cincodenada/old_controllers-pcb/controllerpro.kicad_pcb

## KiCad design controllerpro.kicad_pcb (2019-10-11)

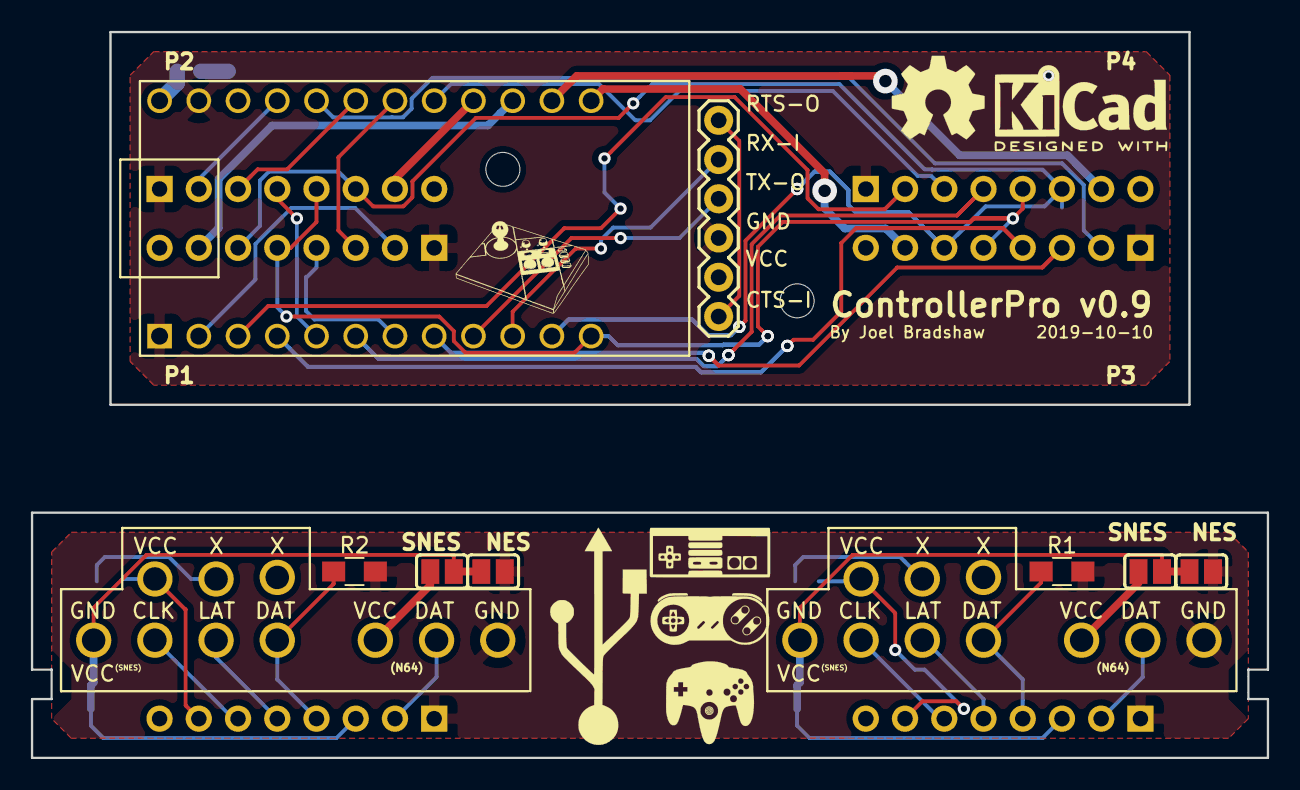
[picture p32: board controllerpro.kicad_pcb from above]

Board: 2 copper layers, 80.0 x 47.0 mm, 21 parts (0 on the bottom side), 40 nets.

Parts:
JP1, JP3, JP4, JP6, JP7, JP8, JP9: SolderJumper_2_Open; SOLDERJUMPER
JP2, JP5: SolderJumper_2_Bridged; SOLDERJUMPER
P1, P2: Conn_01x08_Male; PinHeader_1x08_P2.54mm_Vertical
R1, R2: 10k; R_0805_HandSoldering
S1, S2, S3, S4: Conn_01x08_Female; Socket_Strip_Angled_1x08_Pitch2.54mm
U1: Teensy3.2; Teensy30_31_32_LC
U2: RN42
U3, U4: NINTENDO-MULTI_LARGE; NINTENDO-MULTI

Connections:
/BT_RX: U1.10, U2.RX-I
/BT_TS: U2.CTS-I, U2.RTS-0
/BT_TX: U1.9, U2.TX-0
/CLOCK: S1.6, S2.6, S3.6, S4.6, U1.11
/Child Board/CLK_A: P2.6, U3.2
/Child Board/CLK_B: P1.6, U4.2
/Child Board/ENABLE_A: JP8.1, P2.7, U3.10
/Child Board/ENABLE_B: JP9.1, P1.7, U4.10
/Child Board/FAST_DATA_A: P2.2, U3.6
/Child Board/FAST_DATA_B: P1.2, U4.6
/Child Board/LATCH_A: P2.5, U3.3
/Child Board/LATCH_B: P1.5, U4.3
/Child Board/SLOW_DATA_A: P2.4, R1.1, U3.4
/Child Board/SLOW_DATA_B: P1.4, R2.1, U4.4
/Child Board/S_OR_NES_A: JP2.1, JP2.2, JP3.2, JP4.1, P2.3, U3.1
/Child Board/S_OR_NES_B: JP5.1, JP5.2, JP6.2, JP7.1, P1.3, U4.1
/LATCH: S1.5, S2.5, S3.5, S4.5, U1.12
ENABLE1: S1.7, U1.24
ENABLE2: S2.7, U1.25
ENABLE3: S3.7, U1.22
ENABLE4: S4.7, U1.23
FAST_DATA1: S1.2, U1.2
FAST_DATA2: S2.2, U1.30
FAST_DATA3: S3.2, U1.29
FAST_DATA4: S4.2, U1.3
GND: S1.1, S2.1, S3.1, S4.1, U1.1, U1.32, U2.GND
GNDA: JP4.2, JP7.2, P1.1, P2.1, R1.2, R2.2, U3.7, U4.7
unnamed: JP1.2, U1.33
unnamed: JP8.2, U3.9
unnamed: JP9.2, U4.9
SLOW_DATA1: S1.4, U1.7
SLOW_DATA2: S2.4, U1.5
SLOW_DATA3: S3.4, U1.4
SLOW_DATA4: S4.4, U1.6
S_OR_NES1: S1.3, U1.27
S_OR_NES2: S2.3, U1.28
S_OR_NES3: S3.3, U1.8
S_OR_NES4: S4.3, U1.26
VCC: JP1.1, S1.8, S2.8, S3.8, S4.8, U1.31, U2.VCC
VCCA: JP3.1, JP6.1, P1.8, P2.8, U3.5, U4.5
