cincodenada/old_controllers-pcb/(commit log)

2018-03-31 Initial commit from import
    [controllerpro.kicad_pcb, controllerpro.sch]
2018-03-31 Align board to grid, add border for small board
    [controllerpro.kicad_pcb]
2018-03-31 Add headers, lots of rearranging/tidying
    [controllerpro.sch]
2018-03-31 Shorted connectors to test connectivity
    [controllerpro.sch]
2018-03-31 Revert "Shorted connectors to test connectivity"
    This reverts commit bff4c321492e34593da7785c8a90028fe11ea69b.
    [controllerpro.sch]
2018-04-01 Match footprints and re-label
    [controllerpro.kicad_pcb, controllerpro.sch]
2018-04-01 Move second set of multiports
    [controllerpro.kicad_pcb]
2018-04-01 Start laying out board
    [controllerpro.kicad_pcb]
2018-04-01 More layout
    [controllerpro.kicad_pcb]
2018-04-01 Remove stray vcc labels
    [controllerpro.sch]
2018-04-01 Make it default to configurable SNES/NES
    [controllerpro.kicad_pcb, controllerpro.sch]
2018-04-01 Finish initial layout of first port
    [controllerpro.kicad_pcb]
2018-04-01 Fix port numbers
    That was annoying, but fine
    [controllerpro.kicad_pcb, controllerpro.sch]
2018-04-01 Place remainder of big footprints
    Resistors still to do
    [controllerpro.kicad_pcb]
2018-04-01 Clear out existing tracks
    [controllerpro.kicad_pcb, controllerpro.sch]
2018-04-01 Connect first two terminals (the easy ones)
    [controllerpro.kicad_pcb]
2018-04-01 Initial complete connection
    [controllerpro.kicad_pcb]
2018-04-01 Scootch the connectors closer
    They're the constraining factor here
    [controllerpro.kicad_pcb]
2018-04-01 First attempt at shrinking board
    [controllerpro.kicad_pcb]
2018-04-01 Tie up loose ends from shrinking board
    [controllerpro.kicad_pcb]
2018-04-01 Fix misalignment/non-centering of pins
    [controllerpro.kicad_pcb]
2018-04-01 Add keepout for bluetooth
    [controllerpro.kicad_pcb]
2018-04-01 Make daughterboards smaller
    [controllerpro.kicad_pcb]
2018-04-01 Attempt to add zones to daughterboard
    [controllerpro.kicad_pcb]
2018-04-01 Work on zones on daughterboards
    Still some figuring to do
    [controllerpro.kicad_pcb, controllerpro.sch]
2018-04-08 Update headers with actual footprint
    [controllerpro.kicad_pcb]
2018-04-08 Update resistor placement
    [controllerpro.kicad_pcb]
2018-04-08 Import solder jumpers from Teensy
    Better than caps/resistors
    [controllerpro.kicad_pcb]
2018-04-08 Set up DRCs for OSHPark
    [controllerpro.kicad_pcb]
2018-04-08 Move measurements to Dwg layer
    WTF silkscreens
    [controllerpro.kicad_pcb]
2018-04-08 Switch Teensy package
    [controllerpro.sch]
2018-04-08 Fix pins on new Teensy
    [controllerpro.sch]
2018-04-08 Update boardfile
    [controllerpro.kicad_pcb]
2018-04-08 Fix board
    [controllerpro.kicad_pcb]
2018-08-09 Remove duplicate board, add cutouts
    [controllerpro.kicad_pcb, controllerpro.sch]
2018-08-09 Update to new libraries and fix buses
    [controllerpro.sch]
2018-08-09 Remove second board from schematic
    [controllerpro.kicad_pcb, controllerpro.sch]
2019-02-05 Add pulldown resistors, shrink child board
    [controllerpro.kicad_pcb, controllerpro.sch]
2019-02-05 Switch to Teensy 3.2 footprint
    [controllerpro.kicad_pcb, controllerpro.sch]
2019-02-05 More 3.2 adjustments
    Make it Teensy2 compatible even, hopefully!
    [controllerpro.kicad_pcb, controllerpro.sch]
2019-02-05 Switch to solder bridges for the SNES mode selectors
    [controllerpro.kicad_pcb, controllerpro.sch]
2019-02-06 Make controller pin holes smaller
    Finally found a datasheet that recommends a reasonable size
    [controllerpro.kicad_pcb]
2019-02-06 Shrink top board considerably
    So much empty space!
    [controllerpro.kicad_pcb]
2019-02-06 Make the bottom board smaller!
    SMALLER SMALLER SMALLER
    [controllerpro.kicad_pcb]
2019-02-06 Silkscreen!!
    Logos! Labels!
    [controllerpro.kicad_pcb]
2019-02-08 Nudge bluetooth, refining silkscreen/labels
    [controllerpro.kicad_pcb, controllerpro.sch]
2019-02-18 Fixes from hardware debugging
    Connect daughterboards to ground (!)
    [controllerpro.kicad_pcb, controllerpro.sch]
2019-02-18 Split LATCH into four
    Also fix misplaced NES VCC (!!) and ports
    [controllerpro.kicad_pcb, controllerpro.sch]
2019-02-18 Make power traces thicker
    [controllerpro.kicad_pcb]
2019-03-14 More tidying
    [controllerpro.kicad_pcb, controllerpro.sch]
2019-03-14 Manually rename ports
    Also match board by timestamp, nice!
    perl -p -i -e 's/\b(PORT|S|P|5VDATA|3VDATA|S_OR_NES|LATCH)1\b/${1}4/g' *
    perl -p -i -e 's/\b(PORT|S|P|5VDATA|3VDATA|S_OR_NES|LATCH)2\b/${1}1/g' *
    perl -p -i -e 's/\b(PORT|S|P|5VDATA|3VDATA|S_OR_NES|LATCH)3\b/${1}2/g' *
    perl -p -i -e 's/\b(PORT|S|P|5VDATA|3VDATA|S_OR_NES|LATCH)0\b/${1}3/g' *
    perl -p -i -e 's/\b(PORT|S|P|5VDATA|3VDATA|S_OR_NES|LATCH)\[0..3\]/${1}[1..4]/g' *
    [controllerpro.kicad_pcb, controllerpro.sch]
2019-03-14 Re-add silkscreens
    [controllerpro.kicad_pcb]
2019-03-15 Silkscreen tweaks
    [controllerpro.kicad_pcb]
2019-03-15 Fix a needlessly squiggly trace
    [controllerpro.kicad_pcb]
2019-08-03 Add a couple more measurements
    [controllerpro.kicad_pcb]
2019-08-03 Add child board heirarchical sheet
    [ChildBoard.sch, controllerpro.sch]
2019-08-04 Move back to one latch, instead try current detect
    [ChildBoard.sch, controllerpro.kicad_pcb, controllerpro.sch]
2019-08-04 Fix connector orientation, get rid of tabs
    [controllerpro.kicad_pcb]
2019-08-04 Move RN42 board
    It's on top which is great but needs to be out from under the Teensy
    [controllerpro.kicad_pcb]
2019-08-04 Switch S_OR_NES and DETECT
    So we can do analog measurements on DETECT
    Abandon running wider lines for these, it'll probably be fine
    [controllerpro.kicad_pcb, controllerpro.sch]
2019-08-05 Connect AGND
    [controllerpro.kicad_pcb, controllerpro.sch]
2019-08-05 Rename a bunch of stuff, switch DETECT back
    [controllerpro.sch]
2019-08-05 Move things around so everything that needs touch has it
    [controllerpro.sch]
2019-08-09 Fix the board up after moving all the pins around
    [ChildBoard.sch, controllerpro.kicad_pcb, controllerpro.sch]
2019-08-09 Fuck the schematic all up
    [ChildBoard.sch, controllerpro.sch]
2019-08-09 Start repairs
    [controllerpro.kicad_pcb]
2019-08-09 Finish reworking all the things
    [ChildBoard.sch, controllerpro.kicad_pcb, controllerpro.sch]
2019-08-09 Use local labels instead of global and add NCs
    [ChildBoard.sch, controllerpro.sch]
2019-08-09 I don't even know what I did this time
    [ChildBoard.sch, controllerpro.kicad_pcb, controllerpro.sch]
2019-08-09 Silkscreen updates, tiny tweaks
    [controllerpro.kicad_pcb]
2019-08-13 Add optional pulldown resistors
    Just in case, doesn't hurt to have 'em
    [ChildBoard.sch, controllerpro.kicad_pcb, controllerpro.sch]
2019-08-16 Make child boards flippable
    A little bigger, but hopefully only temporarily
    [ChildBoard.sch, controllerpro.kicad_pcb, controllerpro.sch]
2019-08-16 Connect remaining inputs to child boards
    They don't do anything yet, but why not futureify it
    [ChildBoard.sch, controllerpro.kicad_pcb, controllerpro.sch]
2019-08-17 Flip alternate headers
    Would have made the controllers upside-down again
    [controllerpro.kicad_pcb]
2019-08-28 Initial rejiggering for 5V enable
    [ChildBoard.sch, controllerpro.kicad_pcb, controllerpro.sch]
2019-08-28 Rework connections on child boards only
    [controllerpro.sch]
2019-10-07 Update board
    I don't know why this didn't pick up the first time
    [controllerpro.kicad_pcb]
2019-10-07 Add mounting holes, update to 0.8.2
    [controllerpro.kicad_pcb]
2019-10-10 Update silkscreens
    [controllerpro.kicad_pcb]
2019-10-10 Don't connect extra VCC by default
    [ChildBoard.sch, controllerpro.kicad_pcb, controllerpro.sch]
2019-10-11 Fix mapping and ports
    God, what a mess
    [ChildBoard.sch, controllerpro.kicad_pcb, controllerpro.sch]
2019-10-11 Make trace less circuitous
    [controllerpro.kicad_pcb]
2019-10-11 Make version 0.9
    We've changed enough here
    [controllerpro.kicad_pcb]
2019-10-11 Tidy up refs
    [controllerpro.kicad_pcb]
2019-10-25 Text updates, add link to STL for jig
